DongFengPo1412/All-in-One-Smart-Access-Control-System/docs/images/demo_as608_fingerprint.png

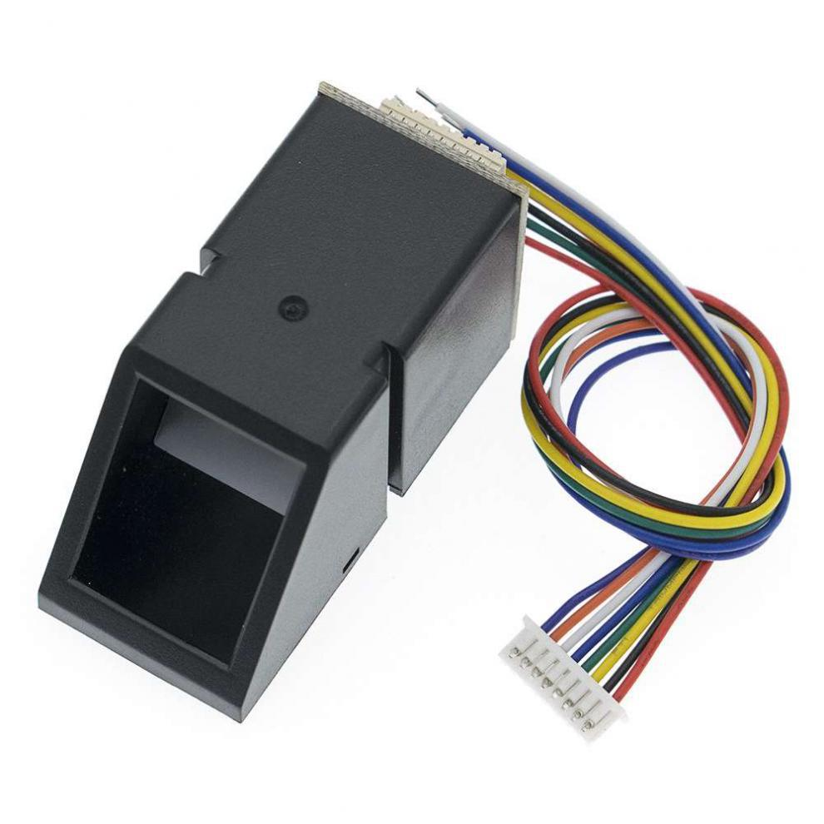
docs/images/demo_as608_fingerprint.png
