DongFengPo1412/All-in-One-Smart-Access-Control-System/docs/images/demo_mfrc522_rfid.png

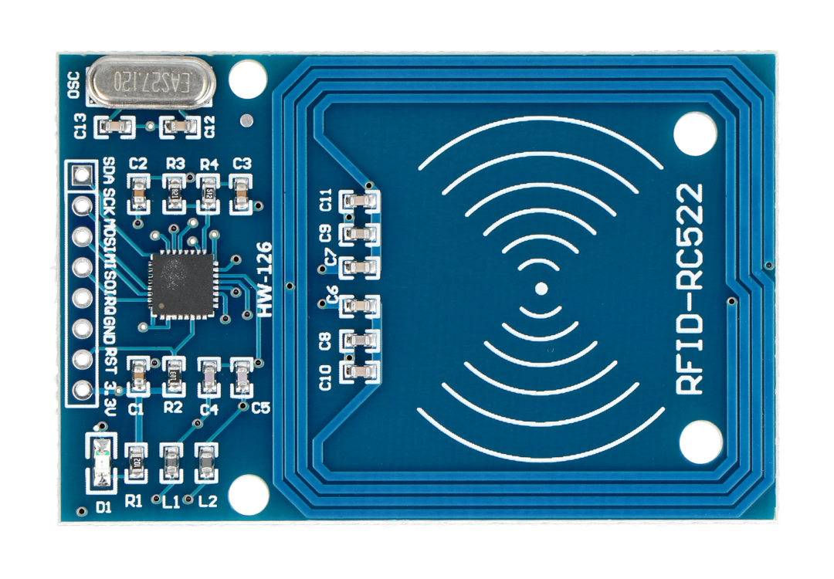
docs/images/demo_mfrc522_rfid.png
