DongFengPo1412/All-in-One-Smart-Access-Control-System/docs/images/demo_oled_display.png

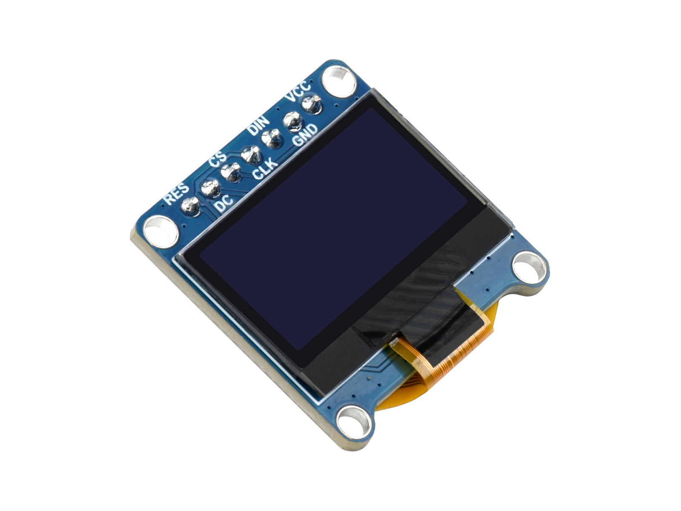
docs/images/demo_oled_display.png
