DongFengPo1412/All-in-One-Smart-Access-Control-System/docs/images/demo_stm32f103_mcu.png

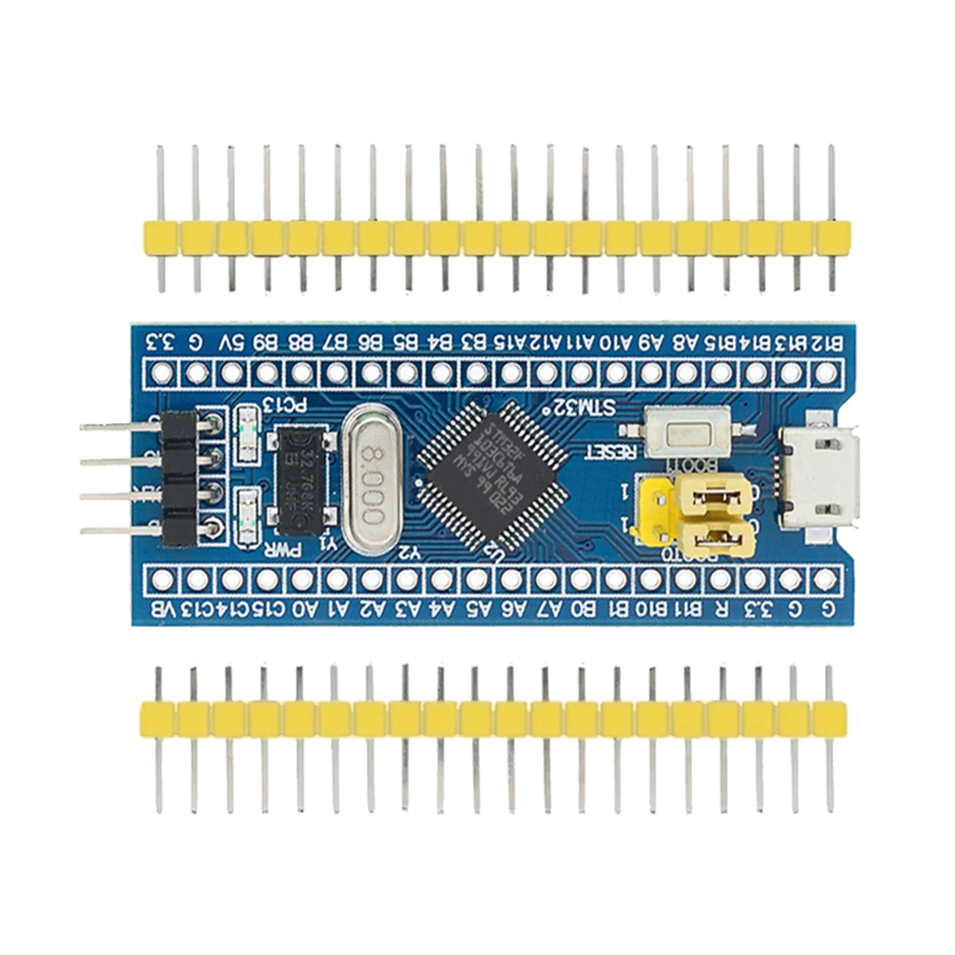
docs/images/demo_stm32f103_mcu.png
