DongFengPo1412/All-in-One-Smart-Access-Control-System/docs/images/system_architecture.png

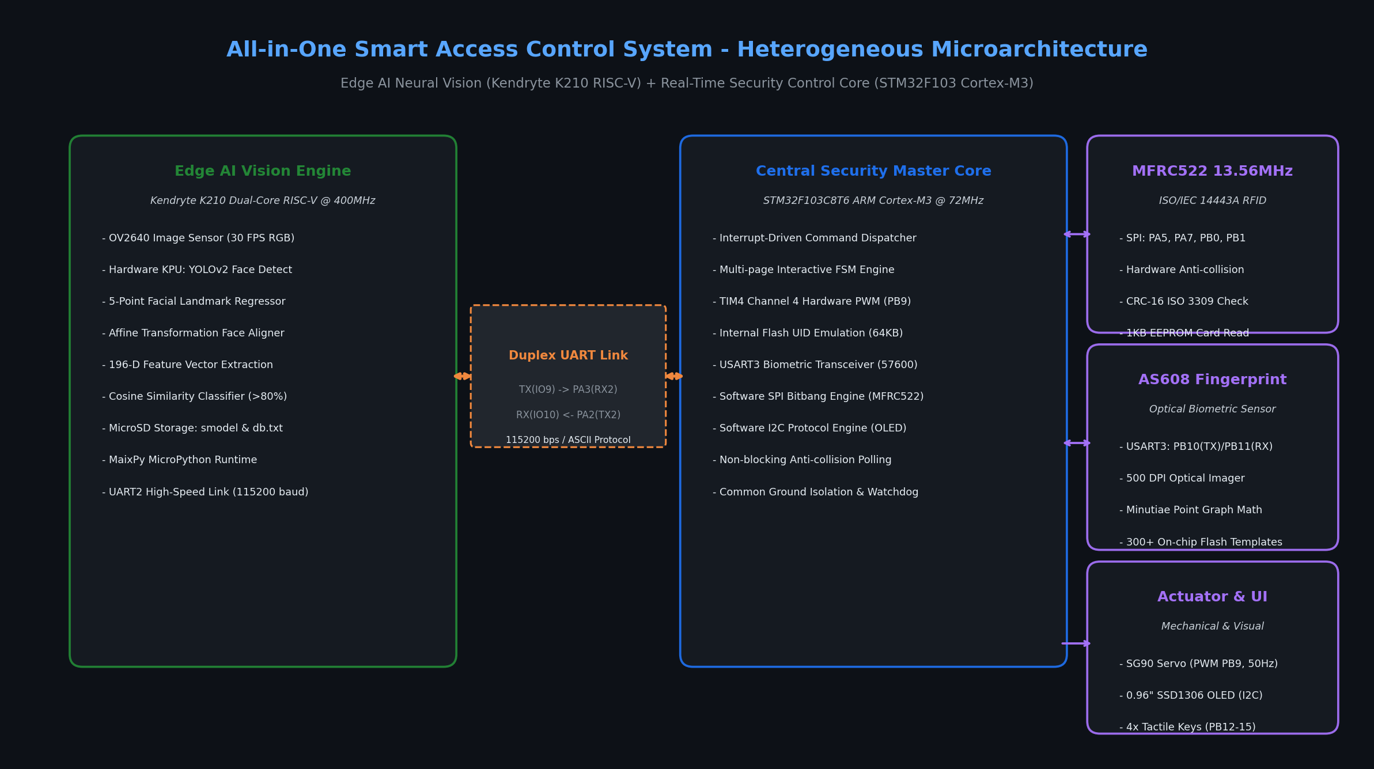
docs/images/system_architecture.png
