DongFengPo1412/All-in-One-Smart-Access-Control-System/Instructions.pdf

# 智慧门禁系统操作说明书

# 第一步物品准备

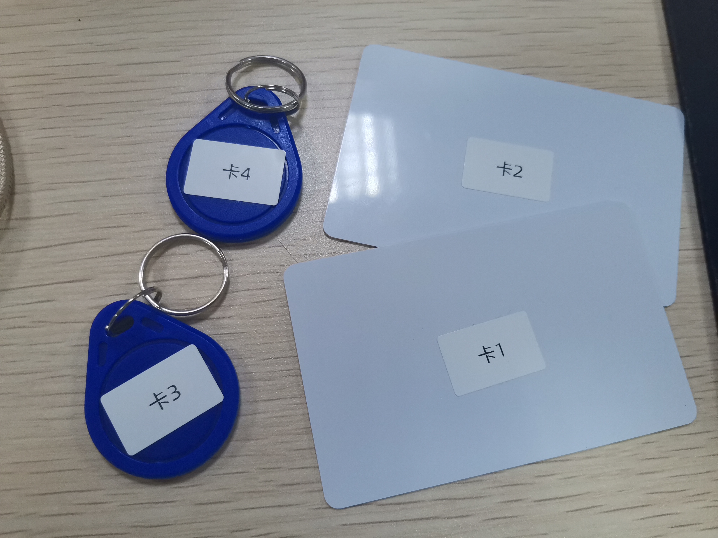
[picture p10: figure]

1. RFID m1卡片，已有4张

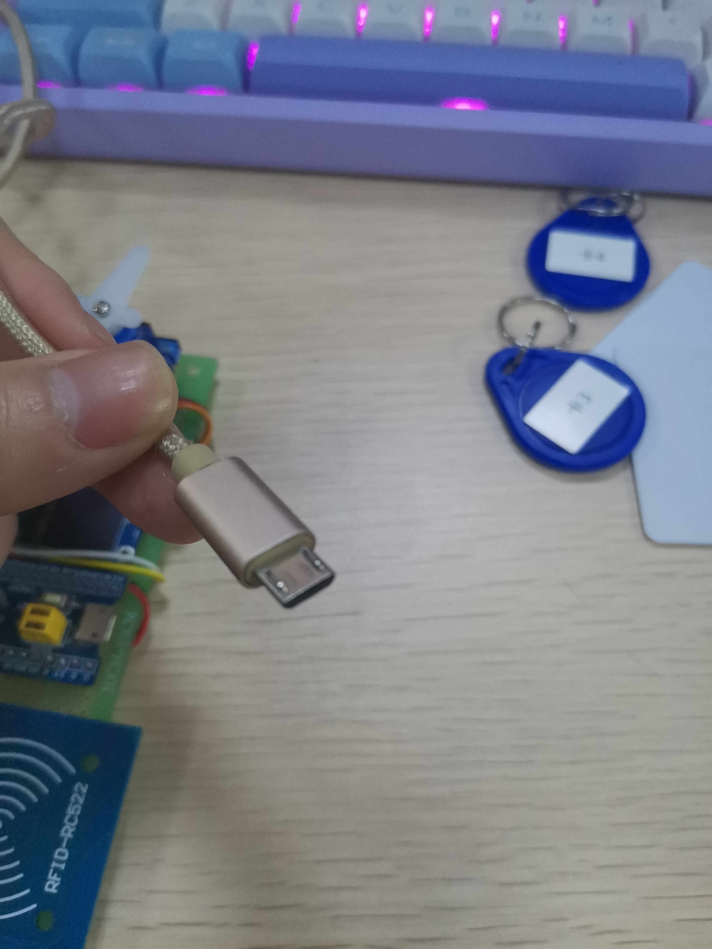
[picture p11: figure]

2. 数据线 microb口，或者typec，用micro-B则接stm32单片机，用typec则接k210

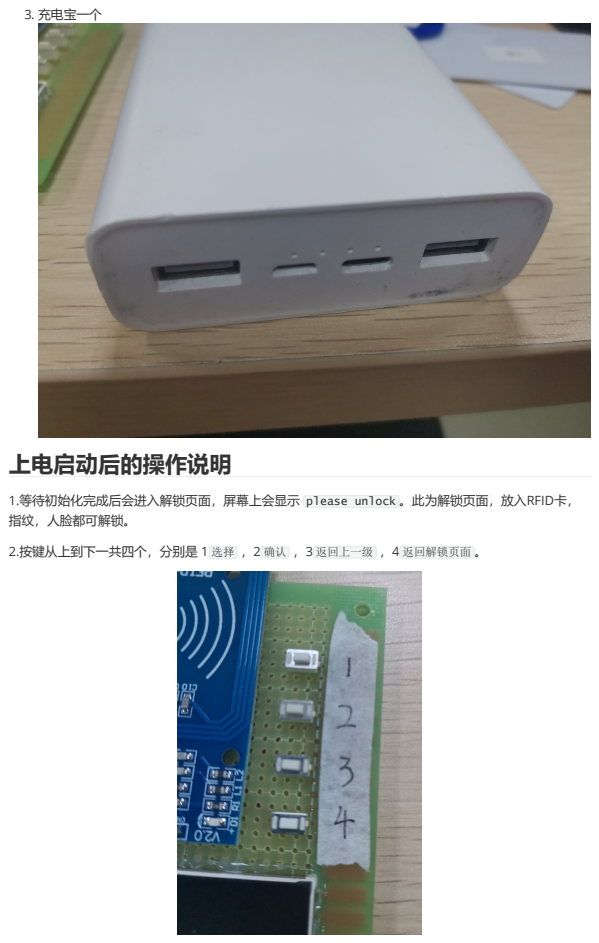
[picture p12: page 3]
3. 充电宝一个; 上电启动后的操作说明

1.等待初始化完成后会进入解锁页面，屏幕上会显示 please unlock 。此为解锁页面，放入RFID卡，
指纹，人脸都可解锁。
2.按键从上到下一共四个，分别是 1 选择 ，2 确认 ，3 返回上一级 ，4 返回解锁页面 。

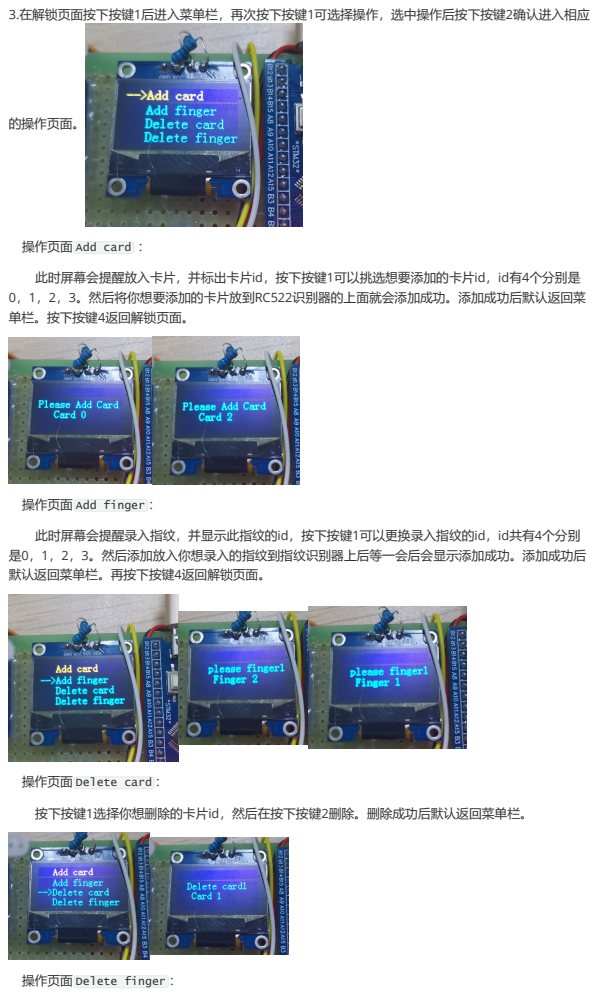
[picture p13: page 4]
3.在解锁页面按下按键1后进入菜单栏，再次按下按键1可选择操作，选中操作后按下按键2确认进入相应; 的操作页面。; 此时屏幕会提醒放入卡片，并标出卡片id，按下按键1可以挑选想要添加的卡片id，id有4个分别是 0，1，2，3。然后将你想要添加的卡片放到RC522识别器的上面就会添加成功。添加成功后默认返回菜 单栏。按下按键4返回解锁页面。; 此时屏幕会提醒录入指纹，并显示此指纹的id，按下按键1可以更换录入指纹的id，id共有4个分别 是0，1，2，3。然后添加放入你想录入的指纹到指纹识别器上后等一会后会显示添加成功。添加成功后 默认返回菜单栏。再按下按键4返回解锁页面。; 按下按键1选择你想删除的卡片id，然后在按下按键2删除。删除成功后默认返回菜单栏。

操作页面 Add card ：

操作页面 Add finger ：

操作页面 Delete card ：

操作页面 Delete finger ：

按下按键1选择你想删除的指纹id，然后再按下按键2删除。删除成功后默认返回菜单栏。

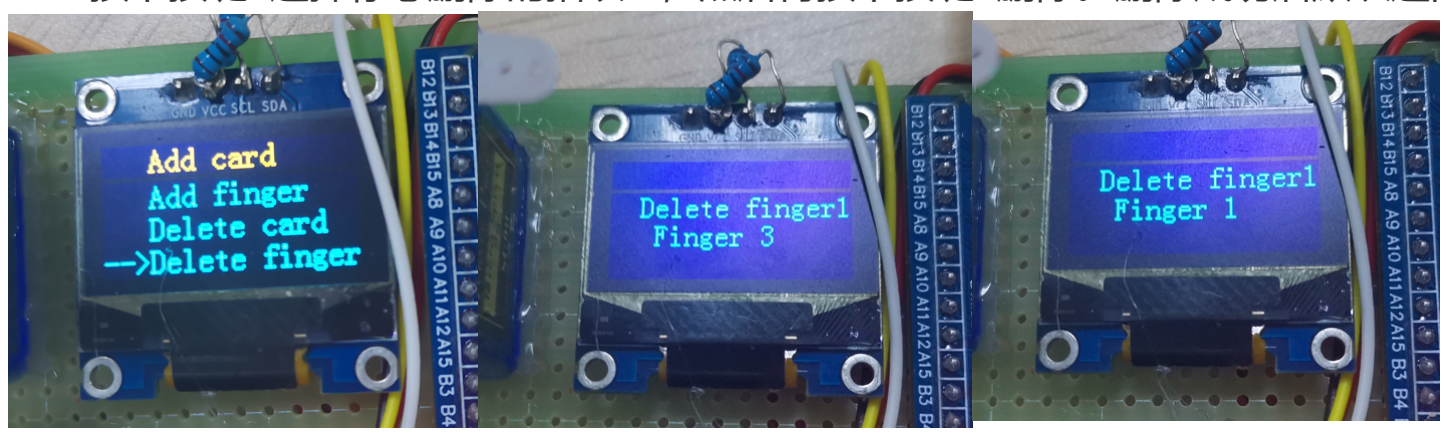
[picture p14: figure]

4.添加人脸的步骤：

将人脸置于摄像头前，若看到人脸被框选后，则可以按下k210左上上角的按键录入人脸。

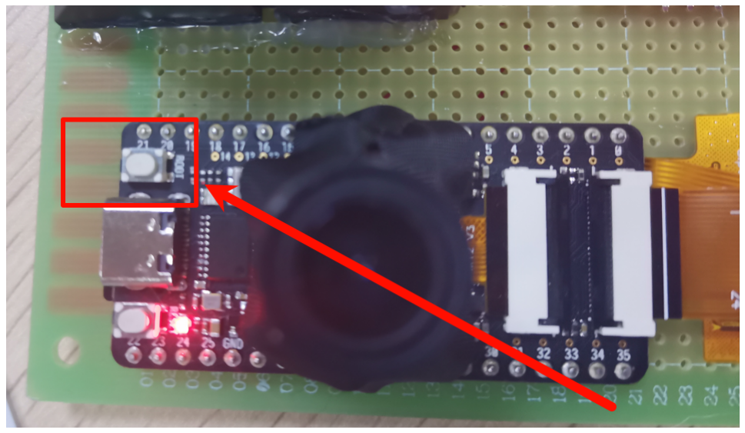
[picture p15: figure]

注意：k210人脸目前最多存储十个，现已存储3个，还剩下7个，后续每次录入人脸就会少一个位置。若 全满了则需要通过以下方法删除人脸。

5.删除人脸的步骤：

取下k210的SD卡，将其放入读卡器中后插入电脑。打卡SD卡中的data.txt文件，将里面的数据全部删 除成为空白文件。此时人脸数据就已经被全部删除了。保存文件后弹出，再插回k210上后就可以继续录 入人脸了。

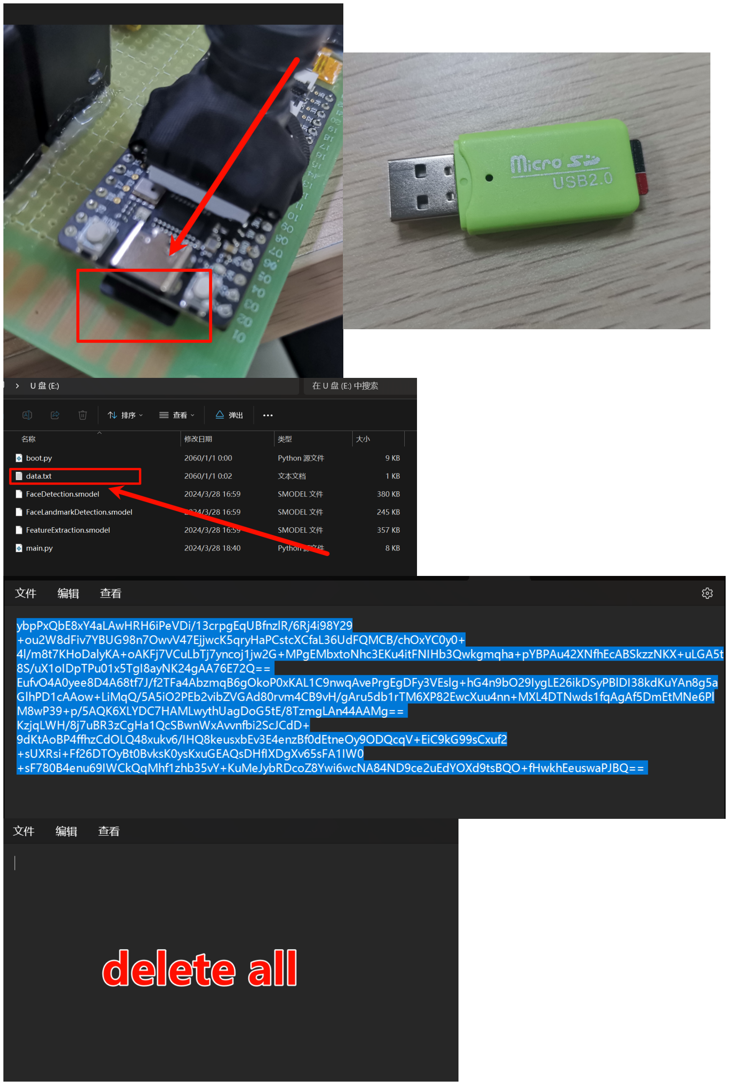
[picture p16: figure]
