DongFengPo1412/All-in-One-Smart-Access-Control-System/docs/images/demo_circuit_wiring.png

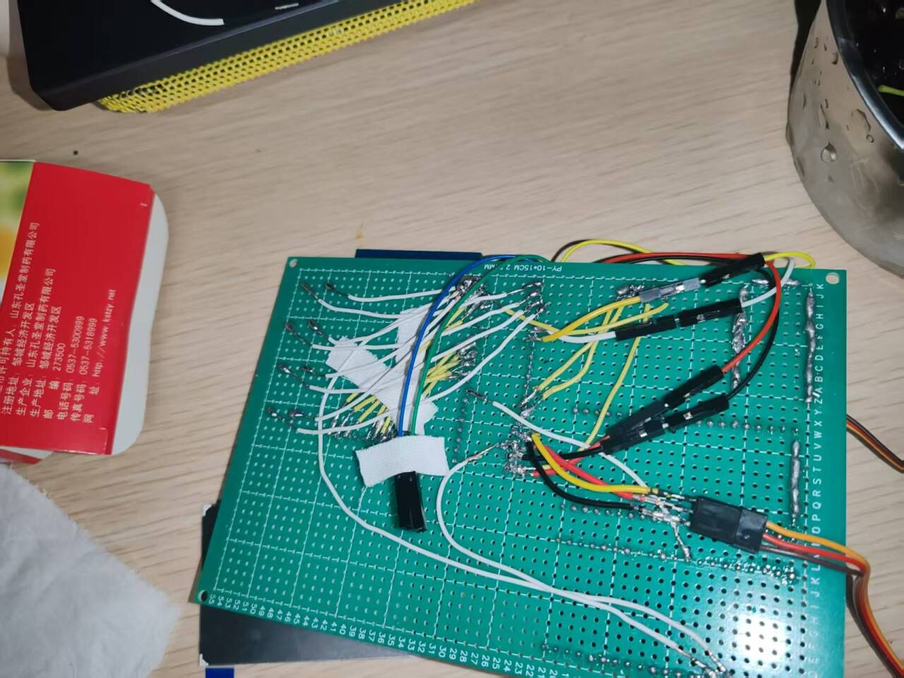
docs/images/demo_circuit_wiring.png
