DongFengPo1412/All-in-One-Smart-Access-Control-System/STM32_Project/Core/Inc/main.h

#define MF522_MISO_Pin GPIO_PIN_5
#define MF522_MISO_GPIO_Port GPIOA
#define MF522_RST_Pin GPIO_PIN_6
#define MF522_RST_GPIO_Port GPIOA
#define MF522_SCK_Pin GPIO_PIN_7
#define MF522_SCK_GPIO_Port GPIOA
#define MF522_SDA_Pin GPIO_PIN_0
#define MF522_SDA_GPIO_Port GPIOB
#define MF522_MOSI_Pin GPIO_PIN_1
#define MF522_MOSI_GPIO_Port GPIOB
#define key1_Pin GPIO_PIN_12
#define key1_GPIO_Port GPIOB
#define key2_Pin GPIO_PIN_13
#define key2_GPIO_Port GPIOB
#define key3_Pin GPIO_PIN_14
#define key3_GPIO_Port GPIOB
#define key4_Pin GPIO_PIN_15
#define key4_GPIO_Port GPIOB
