DongFengPo1412/All-in-One-Smart-Access-Control-System/STM32_Project/Core/Src/usart.c

/**
 ******************************************************************************
 * @file    usart.c
 * @brief   This file provides code for the configuration
 *          of the USART instances.
 ******************************************************************************
 * @attention
 *
 * <h2><center>&copy; Copyright (c) 2021 STMicroelectronics.
 * All rights reserved.</center></h2>
 *
 * This software component is licensed by ST under BSD 3-Clause license,
 * the "License"; You may not use this file except in compliance with the
 * License. You may obtain a copy of the License at:
 *                        opensource.org/licenses/BSD-3-Clause
 *
 ******************************************************************************
 */

/* Includes ------------------------------------------------------------------*/
#include "usart.h"

/* USER CODE BEGIN 0 */
#include <stdio.h>
#include <string.h>

#if (__ARMCC_VERSION >= 6010050)           /* ??AC6???? */
__asm(".global __use_no_semihosting\n\t"); /* ?????????? */
__asm(".global __ARM_use_no_argv \n\t");   /* AC6?????main???????????????????????? */
#else                                      /* ??AC5????, ??????__FILE ? ???????? */
#pragma import(__use_no_semihosting)

/* ??HAL????, ?????????bug */
struct __FILE
{
  int handle;
};
#endif

/* ????????????????_ttywrch\_sys_exit\_sys_command_string??,?????AC6?AC5?? */
int _ttywrch(int ch)
{
  ch = ch;
  return ch;
}

/* ??_sys_exit()?????????? */
void _sys_exit(int x) { x = x; }
char *_sys_command_string(char *cmd, int len) { return NULL; }

/* FILE ? stdio.h????. */
FILE __stdout;

/* MDK??????fputc??, printf?????????fputc???????? */
int fputc(int ch, FILE *f)
{
  HAL_UART_Transmit(&huart3, (uint8_t *)&ch, 1, 0xffff);
  return ch;
}

int fgetc(FILE *f)
{
  uint8_t ch = 0;
  HAL_UART_Receive(&huart3, &ch, 1, 0xffff);
  return ch;
}
/* USER CODE END 0 */
void UsartReceive_IDLE(UART_HandleTypeDef *huart); // 空闲中断回调函数

extern volatile uint8_t face_flag; // 人脸识别标志位

// 接受缓冲区
uint8_t g_usart_rx2_buf[USART_REC_LEN];

/*  接收状态
 *  bit15，      接收完成标志
 *  bit14，      接收到0x0d
 *  bit13~0，    接收到的有效字节数目
 */
uint16_t g_usart_rx_sta = 0;
uint8_t g_rx2_buffer[RXBUFFERSIZE_UART2]; /* HAL库使用的串口接收缓冲 */

static uint8_t rx_work[RXBUFFERSIZE_UART1];
uint8_t aRxBuffer[RXBUFFERSIZE_UART1]; // 接收缓冲
volatile uint16_t RX_len;                        // 接收字节计数

// 定义三个串口句柄
UART_HandleTypeDef huart1;
UART_HandleTypeDef huart2;
UART_HandleTypeDef huart3;
/* USART1 init function */

void MX_USART1_UART_Init(void)
{

  huart1.Instance = USART1;
  huart1.Init.BaudRate = 57600;
  huart1.Init.WordLength = UART_WORDLENGTH_8B;
  huart1.Init.StopBits = UART_STOPBITS_1;
  huart1.Init.Parity = UART_PARITY_NONE;
  huart1.Init.Mode = UART_MODE_TX_RX;
  huart1.Init.HwFlowCtl = UART_HWCONTROL_NONE;
  huart1.Init.OverSampling = UART_OVERSAMPLING_16;
  if (HAL_UART_Init(&huart1) != HAL_OK)
  {
    Error_Handler();
  }
  if (HAL_UART_Receive_IT(&huart1, (uint8_t *)rx_work, RXBUFFERSIZE_UART1) != HAL_OK) // 接收中断打开,空闲中断打开
  {
    Error_Handler();
  }
}

/* USART2 init function */

void MX_USART2_UART_Init(void)
{

  huart2.Instance = USART2;
  huart2.Init.BaudRate = 115200;
  huart2.Init.WordLength = UART_WORDLENGTH_8B;
  huart2.Init.StopBits = UART_STOPBITS_1;
  huart2.Init.Parity = UART_PARITY_NONE;
  huart2.Init.Mode = UART_MODE_TX_RX;
  huart2.Init.HwFlowCtl = UART_HWCONTROL_NONE;
  huart2.Init.OverSampling = UART_OVERSAMPLING_16;
  if (HAL_UART_Init(&huart2) != HAL_OK)
  {
    Error_Handler();
  }
  /* USER CODE BEGIN USART2_Init 2 */
  HAL_UART_Receive_IT(&huart2, (uint8_t *)g_rx2_buffer, RXBUFFERSIZE_UART2);
  /* USER CODE END USART2_Init 2 */
}
void MX_USART3_UART_Init(void)
{

  huart3.Instance = USART3;
  huart3.Init.BaudRate = 115200;
  huart3.Init.WordLength = UART_WORDLENGTH_8B;
  huart3.Init.StopBits = UART_STOPBITS_1;
  huart3.Init.Parity = UART_PARITY_NONE;
  huart3.Init.Mode = UART_MODE_TX_RX;
  huart3.Init.HwFlowCtl = UART_HWCONTROL_NONE;
  huart3.Init.OverSampling = UART_OVERSAMPLING_16;
  if (HAL_UART_Init(&huart3) != HAL_OK)
  {
    Error_Handler();
  }
}

void HAL_UART_MspInit(UART_HandleTypeDef *uartHandle)
{

  GPIO_InitTypeDef GPIO_InitStruct = {0};
  if (uartHandle->Instance == USART1)
  {
    /* USART1 clock enable */
    __HAL_RCC_USART1_CLK_ENABLE();

    __HAL_RCC_GPIOA_CLK_ENABLE();
    /**USART1 GPIO Configuration
    PA9     ------> USART1_TX
    PA10     ------> USART1_RX
    */
    GPIO_InitStruct.Pin = GPIO_PIN_9;
    GPIO_InitStruct.Mode = GPIO_MODE_AF_PP;
    GPIO_InitStruct.Speed = GPIO_SPEED_FREQ_HIGH;
    HAL_GPIO_Init(GPIOA, &GPIO_InitStruct);

    GPIO_InitStruct.Pin = GPIO_PIN_10;
    GPIO_InitStruct.Mode = GPIO_MODE_INPUT;
    GPIO_InitStruct.Pull = GPIO_NOPULL;
    HAL_GPIO_Init(GPIOA, &GPIO_InitStruct);

    /* USART1 interrupt Init */
    HAL_NVIC_SetPriority(USART1_IRQn, 3, 3);
    HAL_NVIC_EnableIRQ(USART1_IRQn);
  __HAL_UART_ENABLE_IT(uartHandle, UART_IT_IDLE);
  }
  else if (uartHandle->Instance == USART2)
  {
    /* USART2 clock enable */
    __HAL_RCC_USART2_CLK_ENABLE();

    __HAL_RCC_GPIOA_CLK_ENABLE();
    /**USART2 GPIO Configuration
    PA2     ------> USART2_TX
    PA3     ------> USART2_RX
    */
    GPIO_InitStruct.Pin = GPIO_PIN_2;
    GPIO_InitStruct.Mode = GPIO_MODE_AF_PP;
    GPIO_InitStruct.Speed = GPIO_SPEED_FREQ_HIGH;
    HAL_GPIO_Init(GPIOA, &GPIO_InitStruct);

    GPIO_InitStruct.Pin = GPIO_PIN_3;
    GPIO_InitStruct.Mode = GPIO_MODE_INPUT;
    GPIO_InitStruct.Pull = GPIO_NOPULL;
    HAL_GPIO_Init(GPIOA, &GPIO_InitStruct);

    /* USART2 interrupt Init */
    HAL_NVIC_SetPriority(USART2_IRQn, 0, 0);
    HAL_NVIC_EnableIRQ(USART2_IRQn);
  }
  else if (uartHandle->Instance == USART3)
  {
    /* USART3 clock enable */
    __HAL_RCC_USART3_CLK_ENABLE();

    __HAL_RCC_GPIOB_CLK_ENABLE();
    /**USART3 GPIO Configuration
    PB10     ------> USART3_TX
    PB11     ------> USART3_RX
    */
    GPIO_InitStruct.Pin = GPIO_PIN_10;
    GPIO_InitStruct.Mode = GPIO_MODE_AF_PP;
    GPIO_InitStruct.Speed = GPIO_SPEED_FREQ_HIGH;
    HAL_GPIO_Init(GPIOB, &GPIO_InitStruct);

    GPIO_InitStruct.Pin = GPIO_PIN_11;
    GPIO_InitStruct.Mode = GPIO_MODE_INPUT;
    GPIO_InitStruct.Pull = GPIO_NOPULL;
    HAL_GPIO_Init(GPIOB, &GPIO_InitStruct);

  }
}

void HAL_UART_MspDeInit(UART_HandleTypeDef *uartHandle)
{

  if (uartHandle->Instance == USART1)
  {
    /* Peripheral clock disable */
    __HAL_RCC_USART1_CLK_DISABLE();

    /**USART1 GPIO Configuration
    PA9     ------> USART1_TX
    PA10     ------> USART1_RX
    */
    HAL_GPIO_DeInit(GPIOA, GPIO_PIN_9 | GPIO_PIN_10);

    /* USART1 interrupt Deinit */
    HAL_NVIC_DisableIRQ(USART1_IRQn);
  }
  else if (uartHandle->Instance == USART2)
  {
    /* Peripheral clock disable */
    __HAL_RCC_USART2_CLK_DISABLE();

    /**USART2 GPIO Configuration
    PA2     ------> USART2_TX
    PA3     ------> USART2_RX
    */
    HAL_GPIO_DeInit(GPIOA, GPIO_PIN_2 | GPIO_PIN_3);

    /* USART2 interrupt Deinit */
    HAL_NVIC_DisableIRQ(USART2_IRQn);
  }
  else if (uartHandle->Instance == USART3)
  {
    /* Peripheral clock disable */
    __HAL_RCC_USART3_CLK_DISABLE();

    /**USART3 GPIO Configuration
    PB10     ------> USART3_TX
    PB11     ------> USART3_RX
    */
    HAL_GPIO_DeInit(GPIOB, GPIO_PIN_10 | GPIO_PIN_11);

  }
}

/* USER CODE BEGIN 1 */
//串口中断回调函数
void HAL_UART_RxCpltCallback(UART_HandleTypeDef *huart)
{
  if (huart->Instance == USART1)
  {
    UsartReceive_IDLE(huart);
  }
  else if (huart->Instance == USART2)
  {
    //多了以下代码就不会出现中断一次卡死的问题，
    static uint8_t ack[] = "OK";
    HAL_UART_Transmit_IT(&huart2, ack, 2);
    //  清楚接收中断标志位
    __HAL_UART_CLEAR_IDLEFLAG(&huart2);
    // 打印接收到的数据是否为'1'，若是则解锁成功
    if (g_rx2_buffer[0] == 0x31)
    {
      face_flag = 1;
      // HAL_UART_Transmit(&huart2, (uint8_t *)"unlock success!\r\n", 17, 0xffff);
    }
    HAL_UART_Receive_IT(&huart2, g_rx2_buffer, RXBUFFERSIZE_UART2);
    __HAL_UART_CLEAR_IDLEFLAG(&huart2);
  }
}

void UsartReceive_IDLE(UART_HandleTypeDef *huart) // 空闲中断回调函数
{
  __HAL_UART_CLEAR_IDLEFLAG(&huart1); // 清除中断

  uint16_t count = RXBUFFERSIZE_UART1 - huart1.RxXferCount;
  HAL_UART_AbortReceive(huart);
  if (RX_len == 0 && count > 0) {
    memcpy(aRxBuffer, rx_work, count);
    RX_len = count; /* publish only after the snapshot is complete */
  }
  HAL_UART_Receive_IT(huart, rx_work, RXBUFFERSIZE_UART1);
}
/* USER CODE END 1 */

/************************ (C) COPYRIGHT STMicroelectronics *****END OF FILE****/
