DongFengPo1412/All-in-One-Smart-Access-Control-System/(commit log)

2026-05-23 Initial commit: 整合STM32与K210的三合一智慧门禁系统
2026-10-22 fix: bound access-control UART parsing and protect RFID flash storage
