DongFengPo1412/All-in-One-Smart-Access-Control-System/(notices)

Notices in the files:
STM32_Project/Core/Inc/main.h:
© Copyright (c) 2020 STMicroelectronics.
All rights reserved.
